snehha/Luminesense/Final_Deliverable/resg-wordle.png

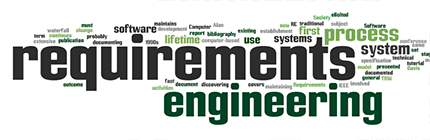
Final_Deliverable/resg-wordle.png
