snehha/Luminesense/Resource GitHub/Hardware Report/Arduino Middle Extension.STL

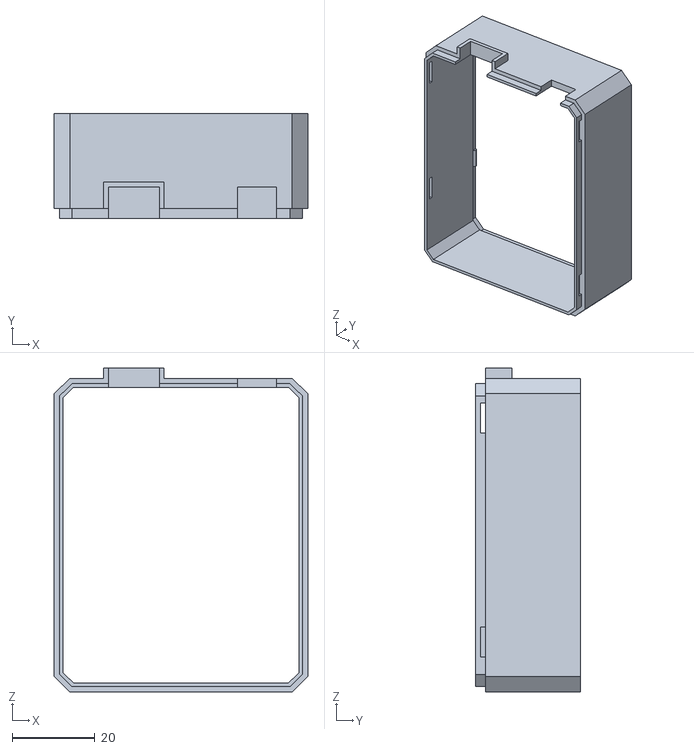
[picture p28: CAD file, 2017-05-01]
Resource GitHub/Hardware Report/Arduino Middle Extension.STL
61.4 x 25.4 x 78.5
