snehha/Luminesense/(commit log)

2016-11-09 IMU Setup with BLE
2016-11-12 Cleaned up IMU setup
2016-11-15 IMU Setup
2017-04-18 added Arduino libraries
2017-05-01 Resource Github submissions
    [Arduino Middle Extension.STL]
